hestela/m5dial-wifi-ntp-server/(commit log)

2026-03-22 set dial to change TZ and button to reset to UTC
    [main.cpp]
2026-03-22 remove seconds from screen, update debug prints
2026-03-22 battery optimizations, use rtc as backup
    turned on wifi power save (may increase ntp latency)
    screen turns off after 10s
    added wifi reconnect logic
2026-03-22 setup on/off button for battery usage only
    this doesnt work right when on usb power due to how things are wired up
2026-03-22 add initial box before parts arrive
    [box.scad]
2026-03-22 fix deprecation warnings and add hostname
    [main.cpp]
2026-03-22 add gps cutout
    [box.scad]
2026-03-22 add fillets
    [box.scad]
2026-03-22 size adjustments
    [box.scad]
2026-03-22 add GET /gps for coordinates and fix stale GPS time bug
    [main.cpp]
2026-03-22 add M3 chamfer
    [box.scad]
2026-03-24 Add recess for m5dial ring
    [box.scad]
2026-03-24 close up the usb port
    [box.scad]
2026-03-25 disable recess around m5dial ring
    [box.scad]
2026-03-25 improve rotary encoder usage
